lamtacta2/NCKH_2021-2023/Report/Bia phu.pdf

TRƯỜNG ĐẠI HỌC THỦ DẦU MỘT

VIỆN KỸ THUẬT – CÔNG NGHỆ

BÁO CÁO TỔNG KẾT
ĐỀ TÀI KHOA HỌC VÀ CÔNG NGHỆ CẤP TRƯỜNG

NGHIÊN CỨU PHÁT TRIỂN MÔ HÌNH BẢN SAO SỐ CHO ROBOT

Mã số: DTSV.22.1-003

Xác nhận của đơn vị chủ trì đề tài | Chủ nhiệm đề tài
(chữ ký, họ và tên) | (chữ ký, họ và tên)

Bình Dương, tháng 07 năm 2023
