lamtacta2/NCKH_2021-2023/Report/Bia.pdf

TRƯỜNG ĐẠI HỌC THỦ DẦU MỘT VIỆN KỸ THUẬT – CÔNG NGHỆ

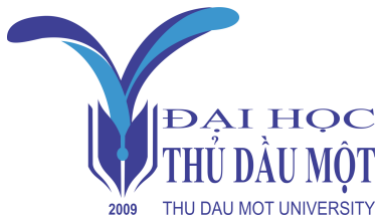
[picture p71: figure]

BÁO CÁO TỔNG KẾT

ĐỀ TÀI KHOA HỌC VÀ CÔNG NGHỆ CẤP TRƯỜNG

### NGHIÊN CỨU PHÁT TRIỂN MÔ HÌNH BẢN SAO SỐ

### CHO ROBOT

### Mã số: DTSV.22.1-003

Chủ nhiệm đề tài: Trần Tuấn Anh
Giảng viên hướng dẫn: TS. Nguyễn Hồ Quang

Bình Dương, tháng 07 năm 2023
