lamtacta2/NCKH_2021-2023/Images/c1.png

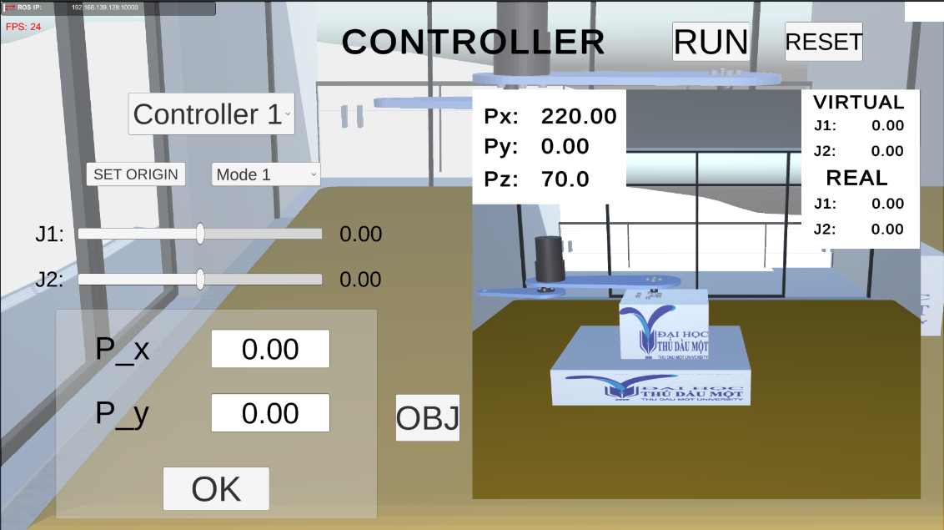
Images/c1.png
