lamtacta2/NCKH_2021-2023/Images/chitiet.png

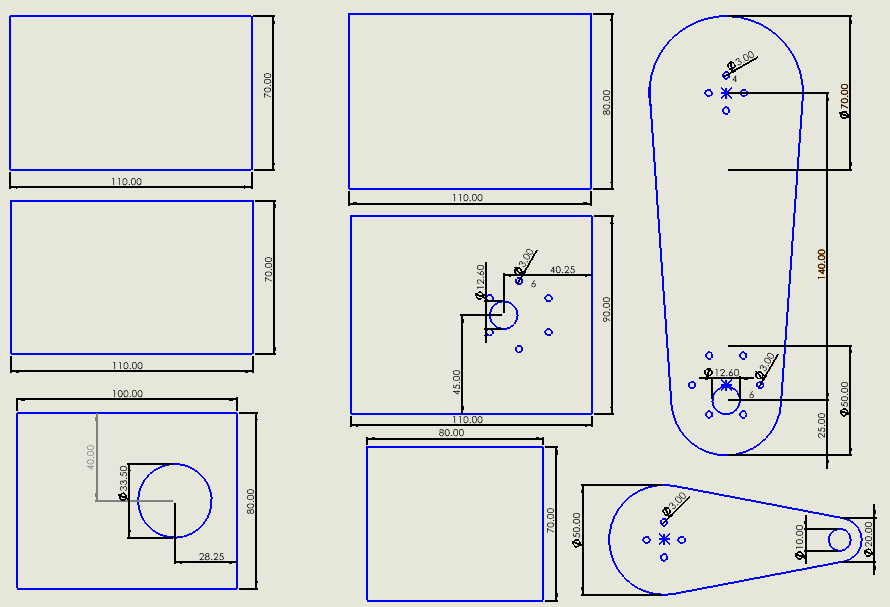
Images/chitiet.png
