lamtacta2/NCKH_2021-2023/Images/error1.png

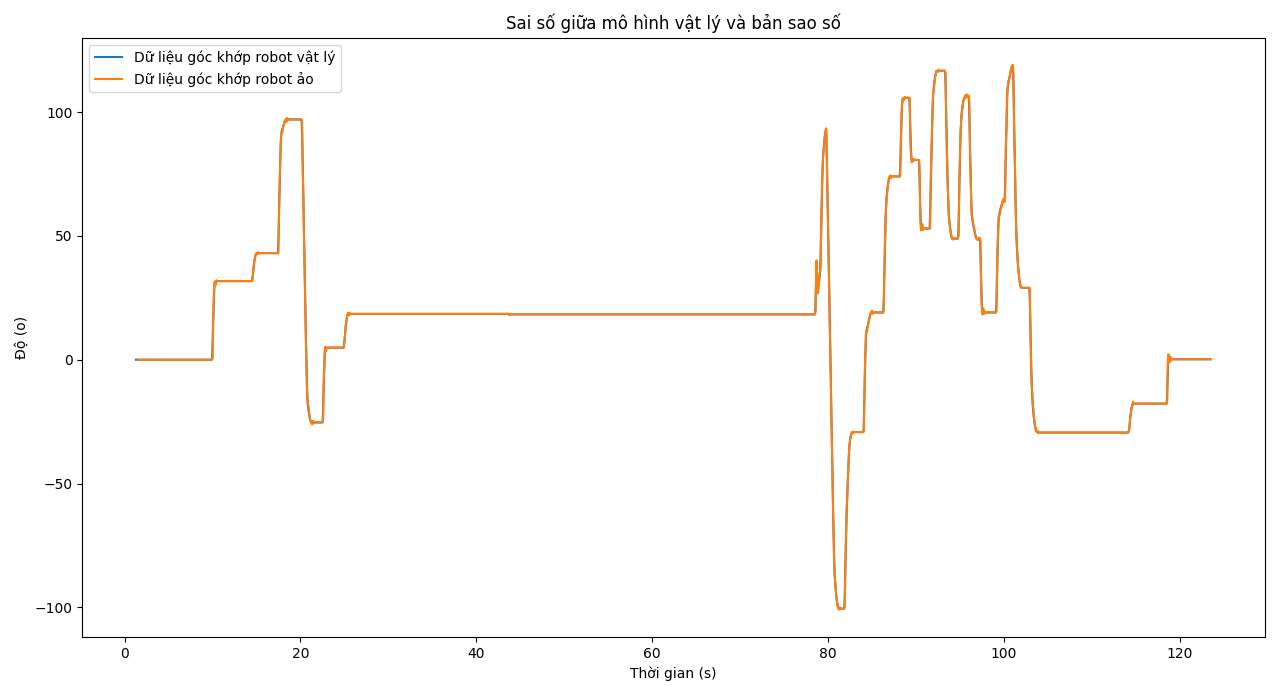
Images/error1.png
