lamtacta2/NCKH_2021-2023/Images/error1_1.png

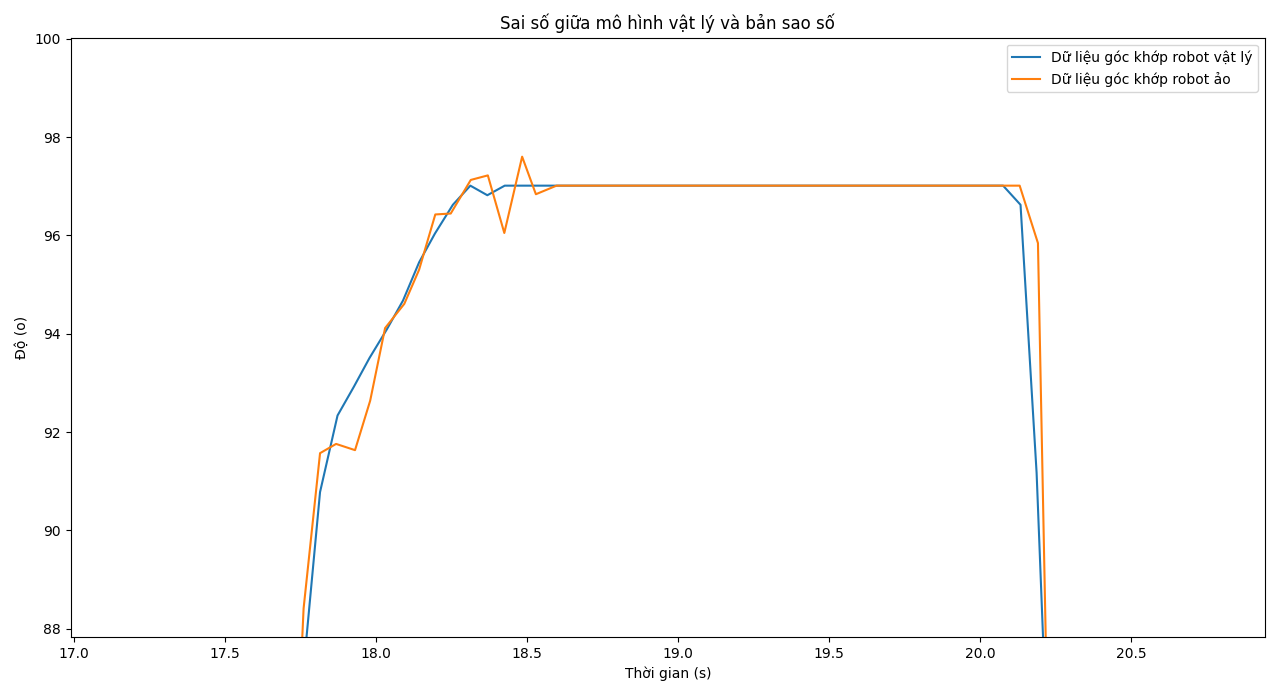
Images/error1_1.png
