lamtacta2/NCKH_2021-2023/Images/errorv.png

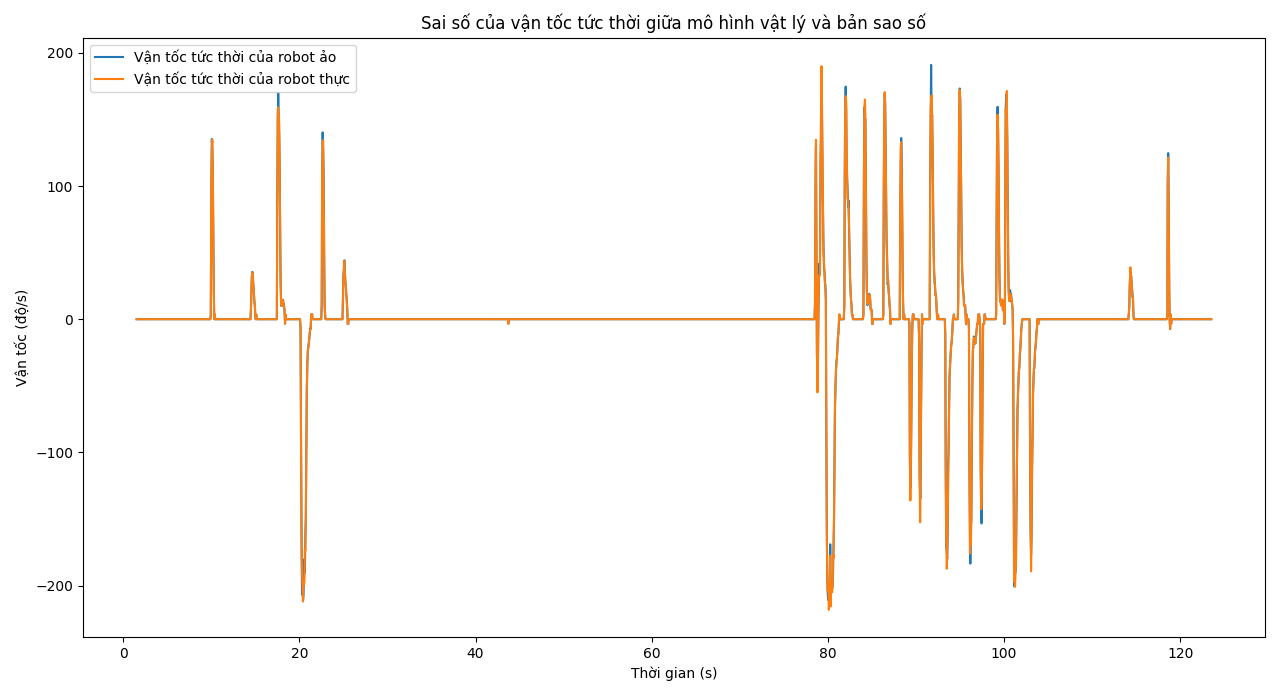
Images/errorv.png
