lamtacta2/NCKH_2021-2023/Images/errorv_1.png

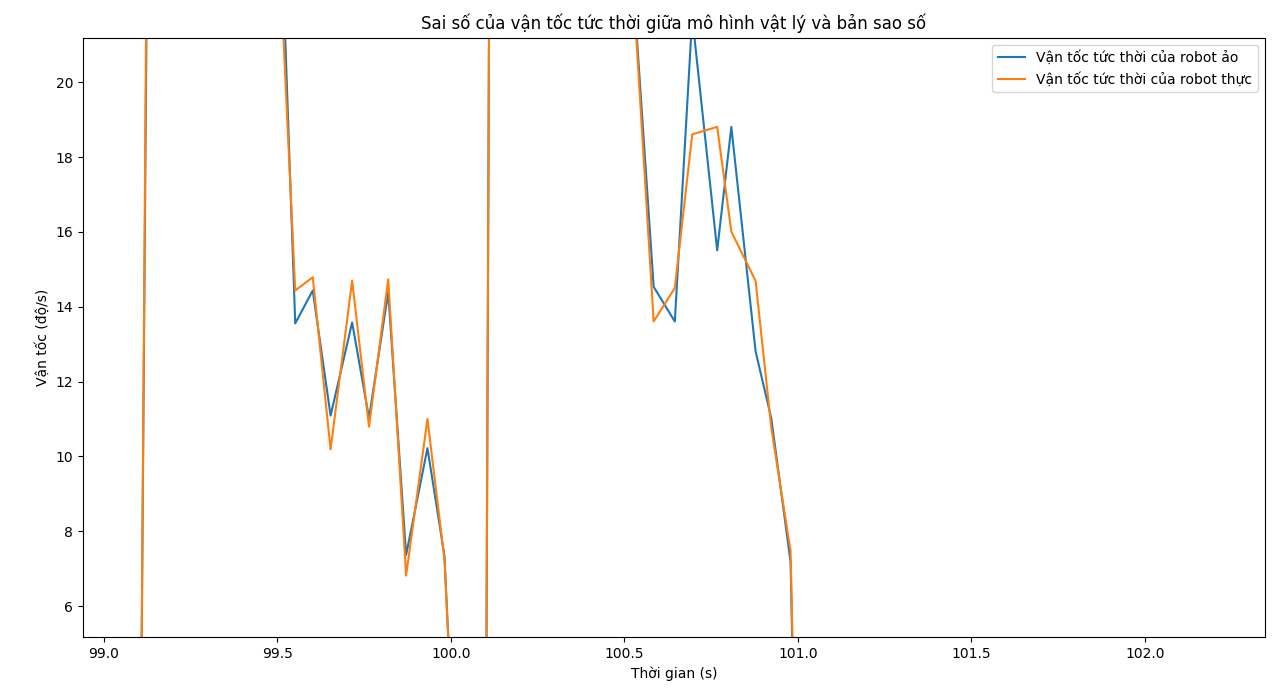
Images/errorv_1.png
