lamtacta2/NCKH_2021-2023/Images/Figure_0.png

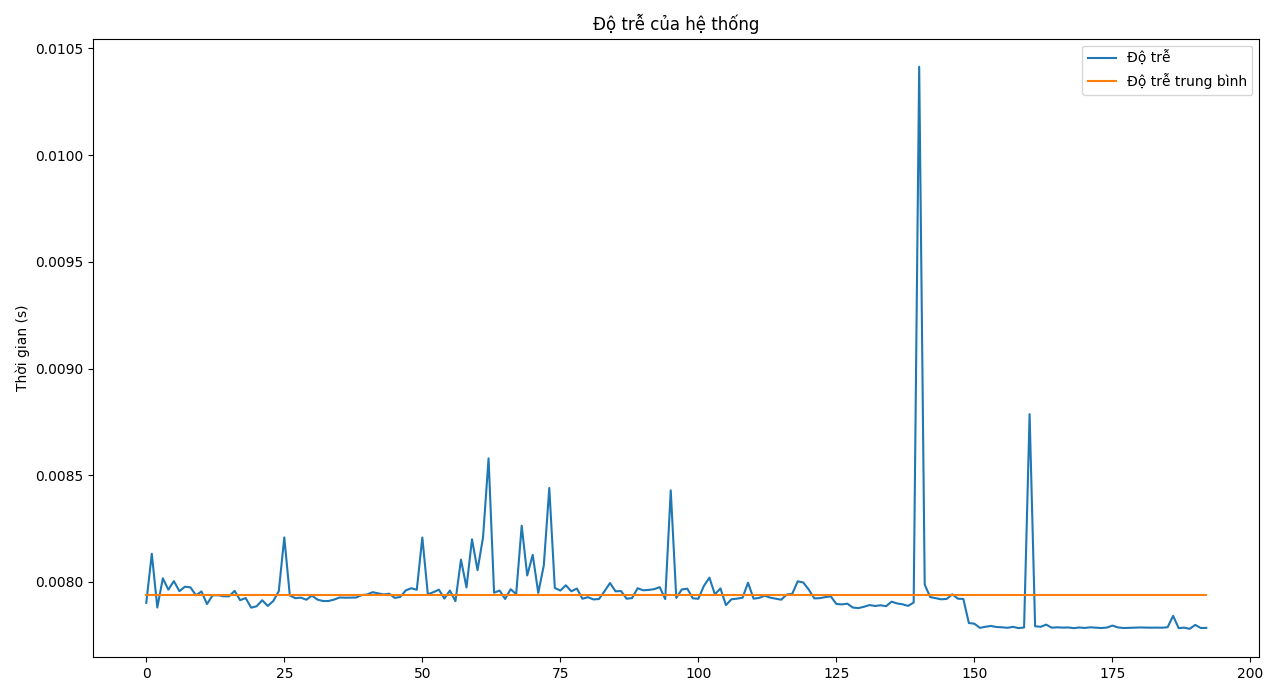
Images/Figure_0.png
