lamtacta2/NCKH_2021-2023/Images/Figure_1.png

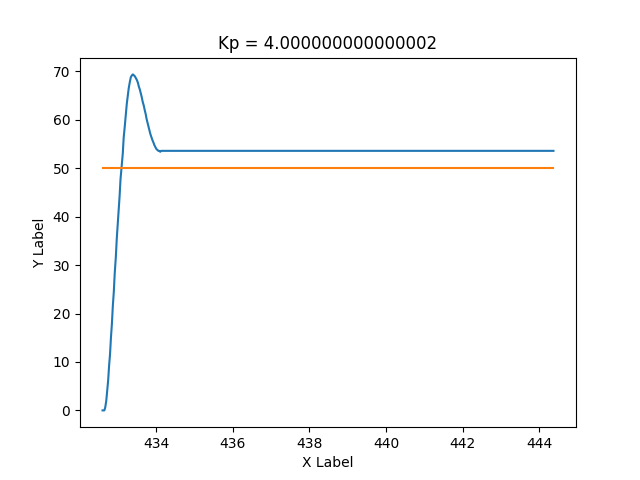
Images/Figure_1.png
