lamtacta2/NCKH_2021-2023/Images/Figure_2.png

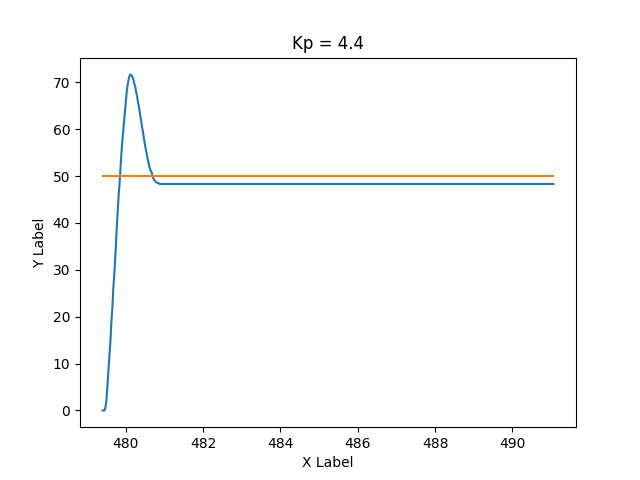
Images/Figure_2.png
