lamtacta2/NCKH_2021-2023/Images/Figure_3.png

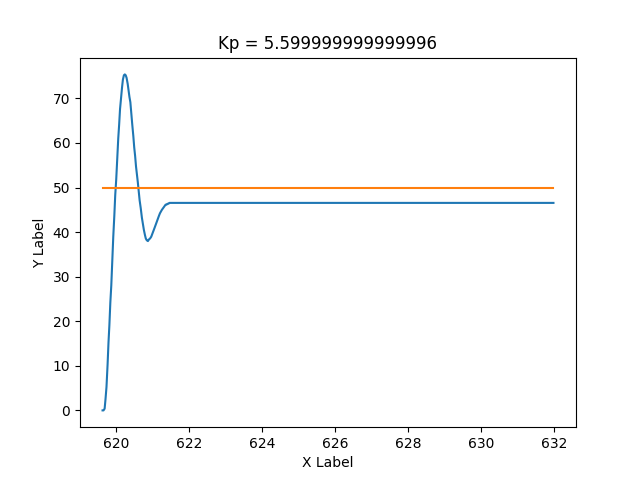
Images/Figure_3.png
