lamtacta2/NCKH_2021-2023/Images/model robot.png

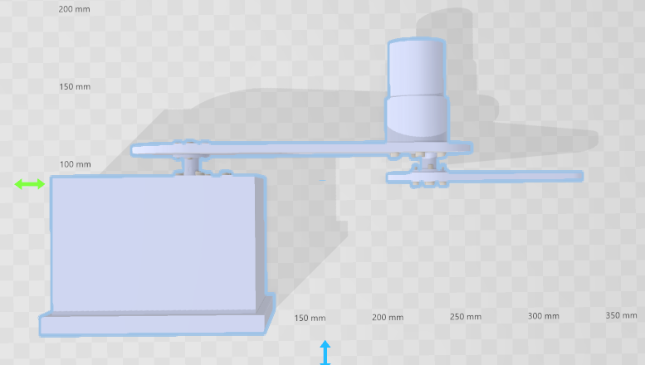
Images/model robot.png
