lamtacta2/NCKH_2021-2023/Images/MĐ.png

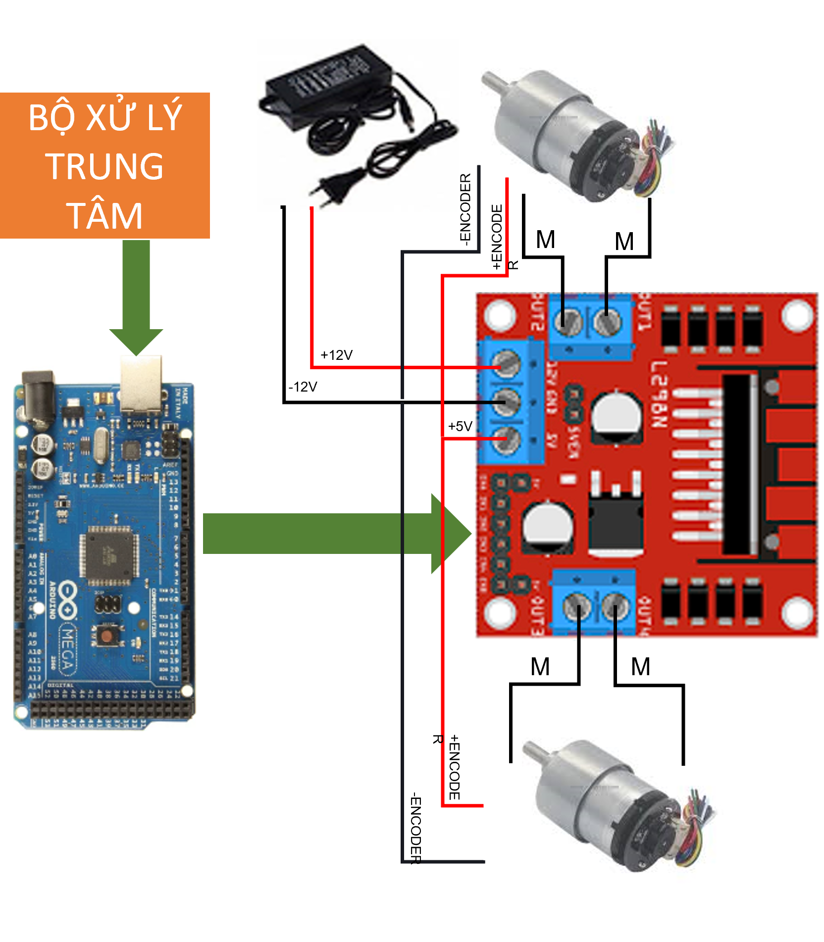
Images/MĐ.png
