lamtacta2/NCKH_2021-2023/Images/overview.png

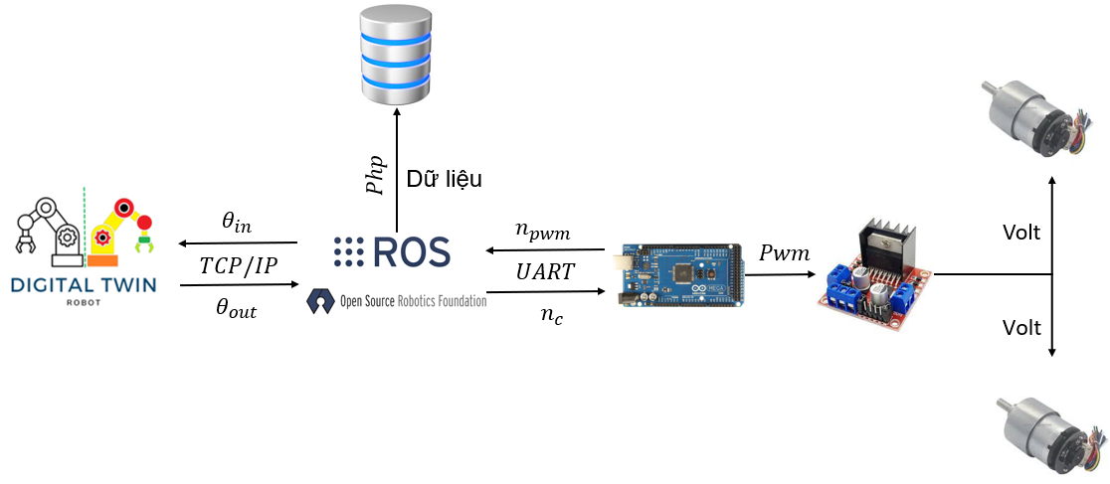
Images/overview.png
