lamtacta2/NCKH_2021-2023/Images/pid_1.png

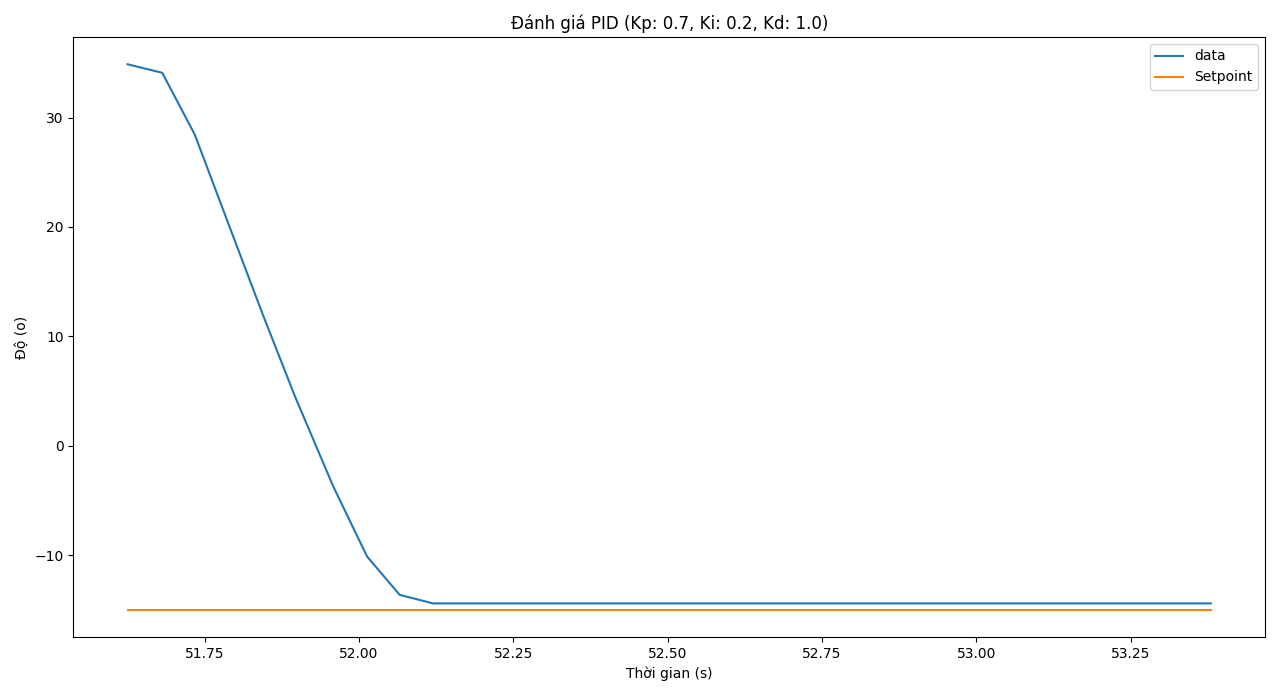
Images/pid_1.png
