lamtacta2/NCKH_2021-2023/Images/pid_2.png

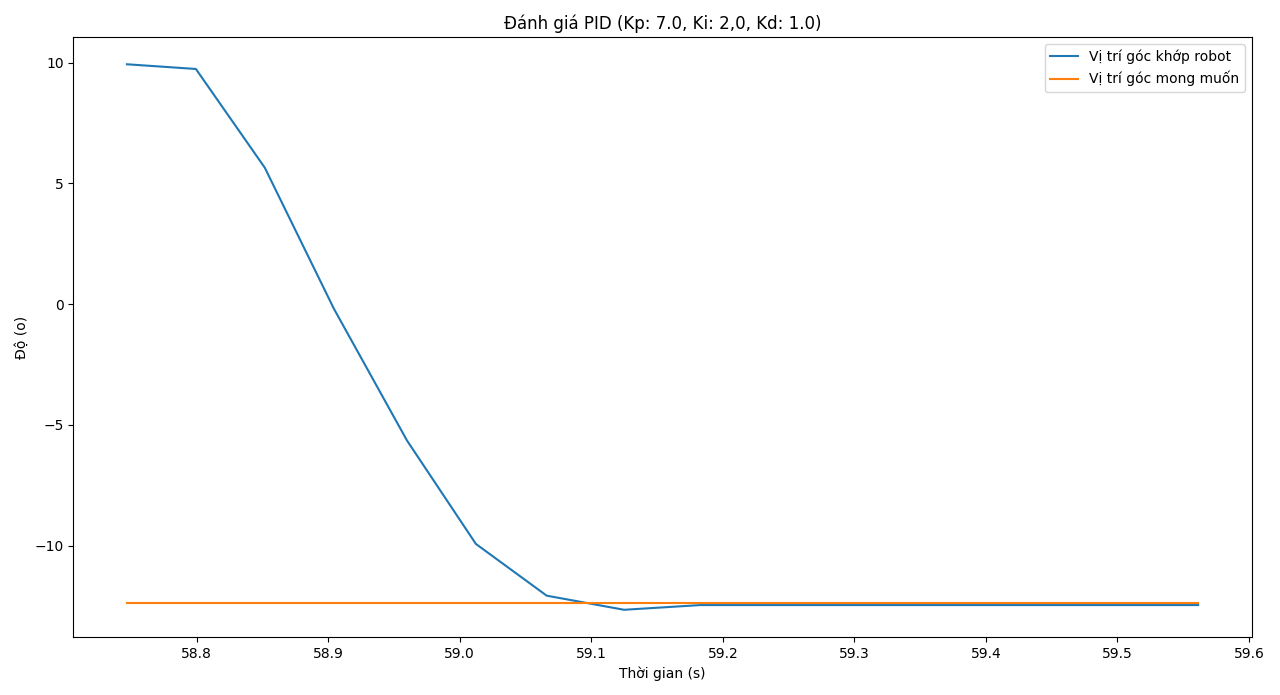
Images/pid_2.png
