lamtacta2/NCKH_2021-2023/Images/pid_4.png

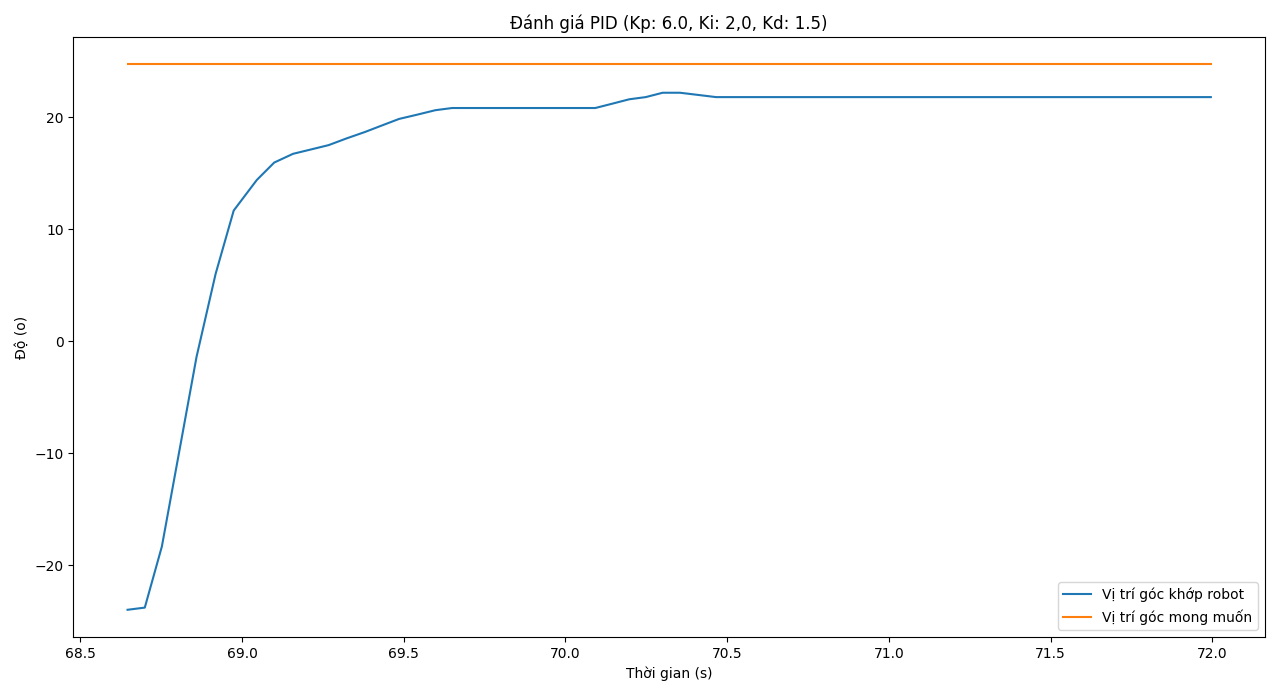
Images/pid_4.png
