lamtacta2/NCKH_2021-2023/Images/r1.png

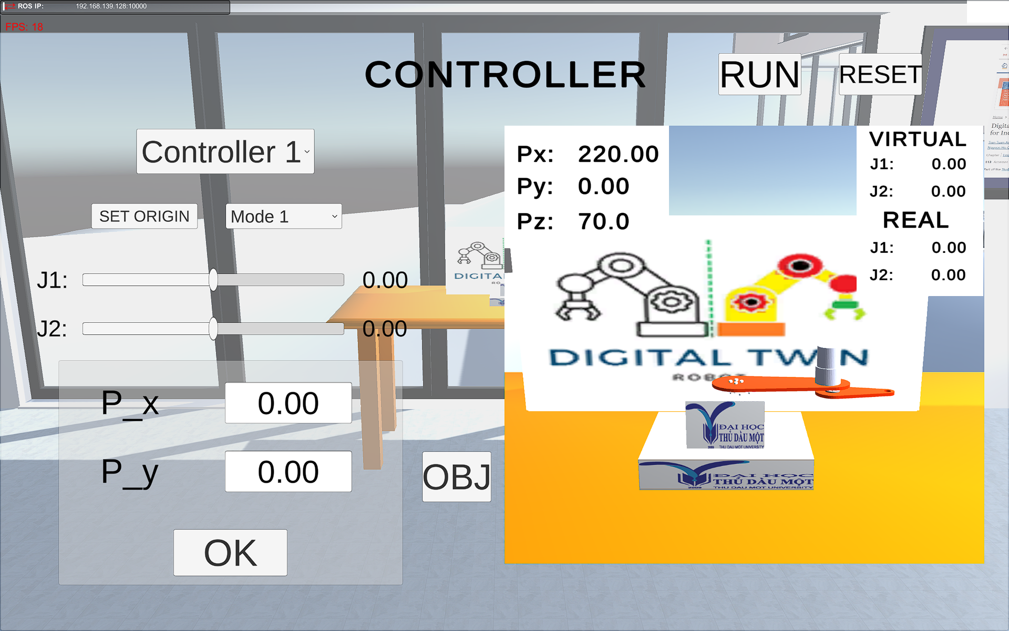
Images/r1.png
