lamtacta2/NCKH_2021-2023/servo/Tutorial.txt

sudo chmod a+rw /dev/ttyACM0
source devel/setup.bash
roslaunch servo servo.launch
rosrun rosserial_python serial_node.py /dev/ttyUSB0
