lamtacta2/NCKH_2021-2023/Code/Test/tutorial.txt

1. 184 Hz --> 50-100 Hz

2. Vẽ sơ đồ (Hàm dữ liệu hệ thống mở)

3. Điều khiển riêng từng động cơ
