lamtacta2/NCKH_2021-2023/CAD/base3.pdf

100 mmØ66
