lamtacta2/NCKH_2021-2023/CAD/Link1.pdf

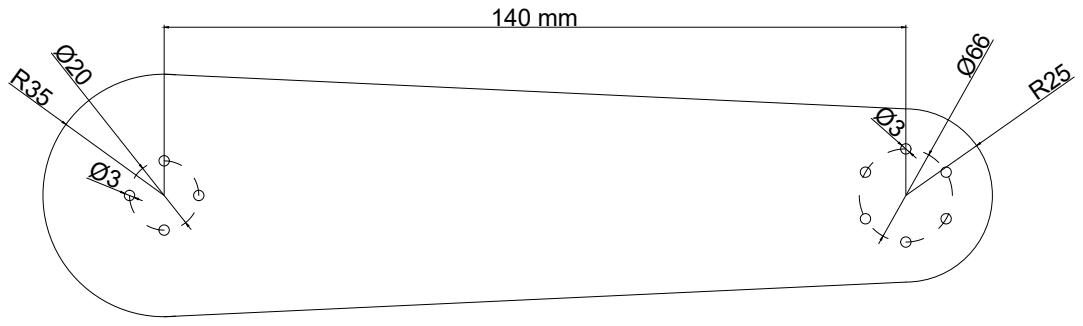
[picture p126: page 1]
