lamtacta2/NCKH_2021-2023/CAD/Link2.pdf

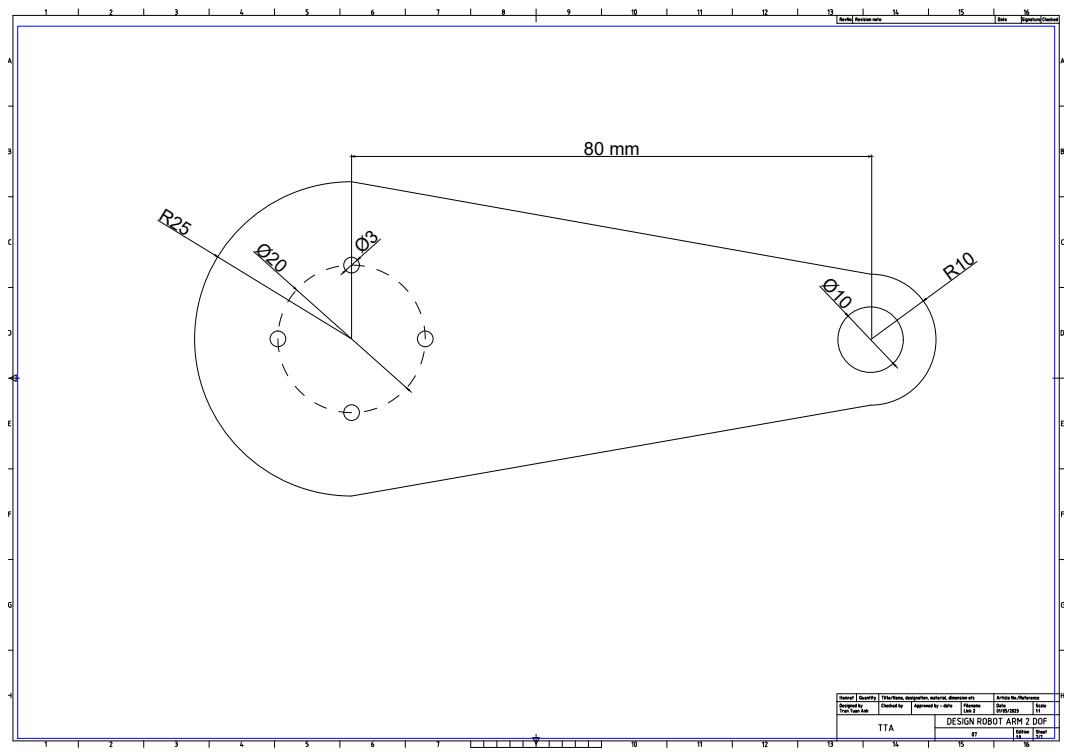
[picture p127: page 1]
